karnxx/printer/README.md

# Conveytor – Conveyor 3D Printer








Conveytor is an open-source conveyor-style 3D printer with a 300×300×250 build area and infinite forward printing.  
It uses a 45° belt setup, an E3D V6 hotend, a 5015 blower, a 3010 hotend fan, and runs Klipper on an SKR Mini E3 V3.

## Specs
- Print area: 300 × 300 × 250  
- Conveyor: unlimited length  
- Hotend: E3D V6  
- Cooling: 5015 part cooling, 3010 hotend fan  
- Firmware: Klipper  
- Board: SKR Mini E3 V3
- Extruder: Dual Gear Drive Mk8

## CAD Model
-https://a360.co/4o4Z37P

## BOM
-[LIVE](https://docs.google.com/spreadsheets/d/1SWROC0y0osU-2LYpqgpzafo1W9ROHyHJvxw4W2zjH10/edit?usp=sharing)

## Revisions-

### Stabilized Gantry
- Increased wall thickness to 6mm  
- Added extension supports on both sides 



### Nozzle Bed Contact
- Adjusted bed position
- Remade belt geometry


### Updated Duct
- Flipped hotend block
- Updated 5015 duct to be flatter


## Optimized prints
- Removed most supports (except fan duct)


## Motor double shear
- Added double shearing, so that the belts can be tensioned safer.


## Added belt tensioning systems
- so that more accurate




## Changed nozzle
- added these extension type thing for more accuracy and length
