karnxx/printer/(list of files, cad)

Other CAD files:
CAD/3D PRINTED PARTS/STEP/TOOLHEAD(1x).step
CAD/3D PRINTED PARTS/STL/roller (2x).stl
CAD/3D PRINTER/priner.step
CAD/3D PRINTED PARTS/STEP/FAN_DUCT(1x).step
CAD/3D PRINTED PARTS/STEP/nema17mounts_both(1x).step
CAD/3D PRINTED PARTS/STEP/doubleshear2(!x).step
CAD/3D PRINTED PARTS/STEP/nemamountconv-z(1x).step
CAD/3D PRINTED PARTS/STEP/cornerprintea (8x).step
CAD/3D PRINTED PARTS/STEP/tensionerouter3(1x).step
CAD/3D PRINTED PARTS/STEP/xypulleys1(1x).step
CAD/3D PRINTED PARTS/STEP/heatbed-mount (4x).step
CAD/3D PRINTED PARTS/STEP/priner_stand(4x).step
CAD/3D PRINTED PARTS/STEP/alumount(1x).step
CAD/3D PRINTED PARTS/STEP/xypulley2(1x).step
CAD/3D PRINTED PARTS/STEP/alumount2(1x).step
CAD/3D PRINTED PARTS/STEP/xy_topandbottom(1x).step
CAD/3D PRINTED PARTS/STEP/alumount3(1x).step
CAD/3D PRINTED PARTS/STEP/tensionerinner2(1x).step
CAD/3D PRINTED PARTS/STEP/roller (1x).step
CAD/3D PRINTED PARTS/STEP/tensionerouter1(1x).step
CAD/3D PRINTED PARTS/STEP/tensionerouter2(1x).step
CAD/3D PRINTED PARTS/STEP/xy2_topandbottom(1x).step
CAD/3D PRINTED PARTS/STEP/roller2 (1x).step
CAD/3D PRINTED PARTS/STEP/doubleshear3(1x).step
CAD/3D PRINTED PARTS/STEP/tensionerinner3(1x).step
CAD/3D PRINTED PARTS/STEP/tensionerinner1(1x).step
CAD/3D PRINTED PARTS/STEP/alumount4(1x).step
CAD/3D PRINTED PARTS/STEP/doubleshear1(!x).step
CAD/3D PRINTED PARTS/STL/FAN_DUCT(1x).stl
CAD/3D PRINTED PARTS/STL/TOOLHEAD(1x).stl
CAD/3D PRINTED PARTS/STL/alumount(1x).stl
CAD/3D PRINTED PARTS/STL/alumount2(1x).stl
CAD/3D PRINTED PARTS/STL/alumount3(1x).stl
CAD/3D PRINTED PARTS/STL/alumount4(1x).stl
CAD/3D PRINTED PARTS/STL/cornerprintea (8x).stl
CAD/3D PRINTED PARTS/STL/doubleshear1(!x).stl
CAD/3D PRINTED PARTS/STL/doubleshear2(!x).stl
CAD/3D PRINTED PARTS/STL/doubleshear3(1x).stl
CAD/3D PRINTED PARTS/STL/heatbed-mount (4x).stl
CAD/3D PRINTED PARTS/STL/nema17mounts_both(1x).stl
CAD/3D PRINTED PARTS/STL/nemamountconv-z(1x).stl
CAD/3D PRINTED PARTS/STL/priner_stand(4x).stl
CAD/3D PRINTED PARTS/STL/tensionerinner1(1x).stl
CAD/3D PRINTED PARTS/STL/tensionerinner2(1x).stl
CAD/3D PRINTED PARTS/STL/tensionerinner3(1x).stl
CAD/3D PRINTED PARTS/STL/tensionerouter1(1x).stl
CAD/3D PRINTED PARTS/STL/tensionerouter2(1x).stl
CAD/3D PRINTED PARTS/STL/tensionerouter3(1x).stl
CAD/3D PRINTED PARTS/STL/xy2_topandbottom(1x).stl
CAD/3D PRINTED PARTS/STL/xy_topandbottom(1x).stl
CAD/3D PRINTED PARTS/STL/xypulley2(1x).stl
CAD/3D PRINTED PARTS/STL/xypulleys1(1x).stl
CAD/3D PRINTER/priner.f3z
